fshen6/pool_fire_experiment_controller-/testing_plan.md

Testing 

first we need to make sure every component works
then we need to test the most basic functions of the system
Finally to test the more complex version of modes of the system.

Test for each component

**Buttons & LCD screen & Potentiometer & toggle**
when buttons are pressed, display it on LCD screemn

**RS485**
1.Give the table for decrypting the data from RS485 and display it in terminal monitor
2.display it on LCD screen too

**MOSFETS**
If button 1 is pressed, close relay 1
if button 2 is pressed close relay 2
if button 3 is pressed, close relay 3
if button 4 is preseed, close relay 4

**PWM sensor**
Send out 10V, use a multimeter to measure this.
Receive data from the voltage sensor to recheck this value.

tell Claude what the system should do and what frame work should i follow.
What would be the structure of the sketch

Basic function (mode 1)
Prime functions, E stops, read values

Basic function (Mode 2)
Adjust the potentiometer and get readings from the voltage sensor, and display them on the LCD screen.

**Potentiometer & PWM sensor & PWM to Voltage convertor & LCD & Buttons & Toggles & rs485**
