fshen6/pool_fire_experiment_controller-/(commit log)

2026-03-27 Add button test with LCD functionality
2026-03-27 Add 3-position toggle switch test
    This file implements a 3-position toggle switch test using two input pins. It reads the state of the toggle and prints the corresponding position to the serial monitor.
2026-03-27 MOSFET test, they do not work, may due to wrong wiring
2026-03-27 potentiometer to PWM converter test code
    It does not work, not sure if its code's problem or hardware problem
2026-04-07 Refactor PwmToVoltConverter for syntax and clarity
    Fixed syntax errors and improved formatting in the PWM to voltage converter code.
2026-04-07 Create VoltMeter
2026-04-07 Replace MOSFET references with Relay in readme
    Updated the readme to replace MOSFET references with Relay for clarity and correctness.
    can not get mosfets to work properly
2026-04-16 Update Mode 2 description in readme.md
    Clarified instructions for Mode 2 functionality and relay operations.
2026-04-16 Enhance readme with RS-485 sensor details
    Added detailed explanation of the RS-485 sensor communication and data processing.
2026-04-16 Update relay configuration in readme.md
    2 relays intead of 3 relays
2026-04-16 Clarify button descriptions in readme.md
2026-04-16 Swap button pin assignments for BTN1 and BTN3
2026-04-16 Fix button pin order in readme.md
2026-04-16 Update SENSOR_RATIO for voltage scaling
2026-04-21 Change button actions from MOSFETs to relays
    Updated button actions to control relays instead of MOSFETs.
2026-04-21 Add Mode_2 for LCD and relay control
2026-04-22 for programm for distance sensor
2026-05-09 Add laser sensor communication and troubleshooting guide
    Documents SDL series RS-485 Modbus RTU protocol, wiring, decoding formula,
    CRC implementation, working code template, and diagnostic troubleshooting
    for common issues (REDE timing, A/B swap, baud mismatch, buffer stale data).
2026-05-09 Add Td measurement experiment — report and Arduino sketch
    Includes structured experiment report (Td_Experiment_Report.md) with
    introduction, procedure, ASCII sample graphs, results table template,
    and application to Mode 3 Smith Predictor. Companion sketch
    (Td_Measurement/Td_Measurement.ino) automates the full measurement:
    30 s noise baseline, step response, 3-sigma detection, process gain
    capture, and multi-trial summary with ready-to-paste Mode 3 constants.
    [Td_Measurement.ino]
2026-05-09 Add Smith Predictor detailed design plan
    Covers full algorithm explanation (pipeline analogy, block diagram,
    discrete update equations), how it handles the observed burn rate
    progression (3.5V→4.0V→4.3V over 30 min), ESP32 timing budget and
    memory layout, complete parameter reference, tuning procedure,
    expected 30-minute run timeline, and failure mode analysis.
2026-05-28 Add Mode_3 sketch (PI + Smith Predictor) and KANBAN board
    Mode_3/Mode_3.ino: automatic fuel level control with:
    - PI outer loop (10 Hz) on distance error with deadband and anti-windup
    - P inner loop (50 Hz) tracking V_cmd via voltage sensor
    - Smith Predictor (toggle via #define) for transport dead-time compensation
    - Bang-bang logic from readme replaced — PI integrator handles 7x burn
    rate variation across fuels automatically without parameter changes
    - E-stop: immediate CCW max drain, fail-safe on wire break
    - CSV serial logging at 100 ms for 30-min run analysis
    - LCD: distance, error, voltage, PWM during run
    KANBAN.md: project task board tracking done/in-progress/blocked/todo
    Co-Auth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
    [Mode_3.ino]
2026-05-28 Fix Mode_3: pot drives pump in IDLE, B3 locks in VStart/DStart
    Before this fix, VStart was captured as 0V because the pump was off
    in IDLE. Now the potentiometer drives the pump CW in IDLE so the user
    can dial in the starting speed; B3 snapshots V_meas/y_real and hands
    control to the PI loop from that operating point (bumpless transfer).
    [Mode_3.ino]
2026-05-28 Add PROGRESS.md — Mode 3 task tracker with status key and critical path
2026-06-09 Add Sensor_Comms_Test sketch for MAX3485 validation
    Polls sensor at 1 Hz, prints raw hex bytes every cycle, decodes distance
    if CRC and frame structure are valid. Built-in diagnosis hints for the
    three most common failure modes (no bytes, wrong frame, partial frame).
    [Sensor_Comms_Test.ino]
2026-06-09 Simplify Sensor_Comms_Test: remove RE/DE pin, auto-direction module
2026-06-13 Restore RE/DE pin control in test sketch; add MAX3485 context file
    Sensor_Comms_Test: RE/DE pin back (new module has the pins).
    MAX3485_SENSOR_CONTEXT.md: self-contained context doc for testing
    the sensor link in a separate conversation.
2026-06-13 Push working MAX3485 sensor sketch; fix distance divisor
    Sketch confirmed working with ESP32 + MAX3485 + SDL laser sensor.
    Fixed division factor: 100000000 → 1000 (raw unit is 1 µm for SDL-100/200/400,
    so dividing by 1000 gives mm).
    [Sensor_Comms_Test.ino]
2026-06-13 Mark H1 complete in PROGRESS.md — sensor comms confirmed working
2026-06-15 Add RS-485 direction switching root cause analysis; fix guide template
    RS485_Direction_Switching_Analysis.md: full explanation of why previous
    sketches failed — two missing delayMicroseconds(200) guards around the
    RE/DE direction switch. Guard 1 (before write) prevents first byte
    corruption. Guard 2 (after flush) prevents false start-bit detection
    when receiver enables. flush() is necessary but not sufficient.
    laser_sensor_comms_guide.md: corrected code template with both guards
    and a cross-reference to the analysis doc.
2026-06-15 Update comms guide: confirmed-working sketch + word-swap decode fix
    Code template replaced with the confirmed-working Sensor_Comms_Test
    sketch (two delayMicroseconds(200) guards, dynamic CRC, signed int32_t).
    Decoding section corrected: sensor sends data word-swapped (low 16-bit
    word first on wire, then high word). Naive big-endian decode is only
    correct for distances < 65.535 mm; word-swap required above that.
2026-06-15 Fix Mode_3 sensor read (guards + word-swap); expand PROGRESS to full todo
    Mode_3/Mode_3.ino:
    - Add two delayMicroseconds(200) guards around RE/DE toggle
    - Fix distance decode: word-swapped (low word first on wire), signed int32_t
    Previous big-endian decode only correct for distances < 65.535 mm
    PROGRESS.md: expanded from 10 tasks to full 5-stage todo list covering
    hardware verification, bench testing, Td experiment, live tuning, and
    validated experiment. H1 marked complete.
    [Mode_3.ino]
2026-06-16 Add Response_Time_Test sketch
    Press B3 → 10s baseline (pump off) → 1s pump burst at PUMP_PWM (~7V)
    → 30s post-record. Logs CSV: timestamp_ms, phase, distance_mm, voltage_V.
    At the end prints distance at pump start so you can find the exact row
    in the CSV where level begins to change — that delta is the response time.
    Uses confirmed-working RS-485 pattern (two delayMicroseconds(200) guards,
    word-swapped decode, HardwareSerial with explicit pins).
    [Response_Time_Test.ino]
2026-06-16 Response_Time_Test: reverse to CCW drain, 5s burst, 60s record
    - Pump now fires CCW (drain) instead of CW (inject)
    - PUMP_ON 5 s, POST_RECORD 60 s
    - Summary text updated: draining drops level so distance INCREASES
    [Response_Time_Test.ino]
